AllDigital33/OpenGSE2.5/Remote Recovery Board/Schematic and PCB/FAR LR1 Remote Recovery Schematic.pdf

## OUTPUT

## BAT +

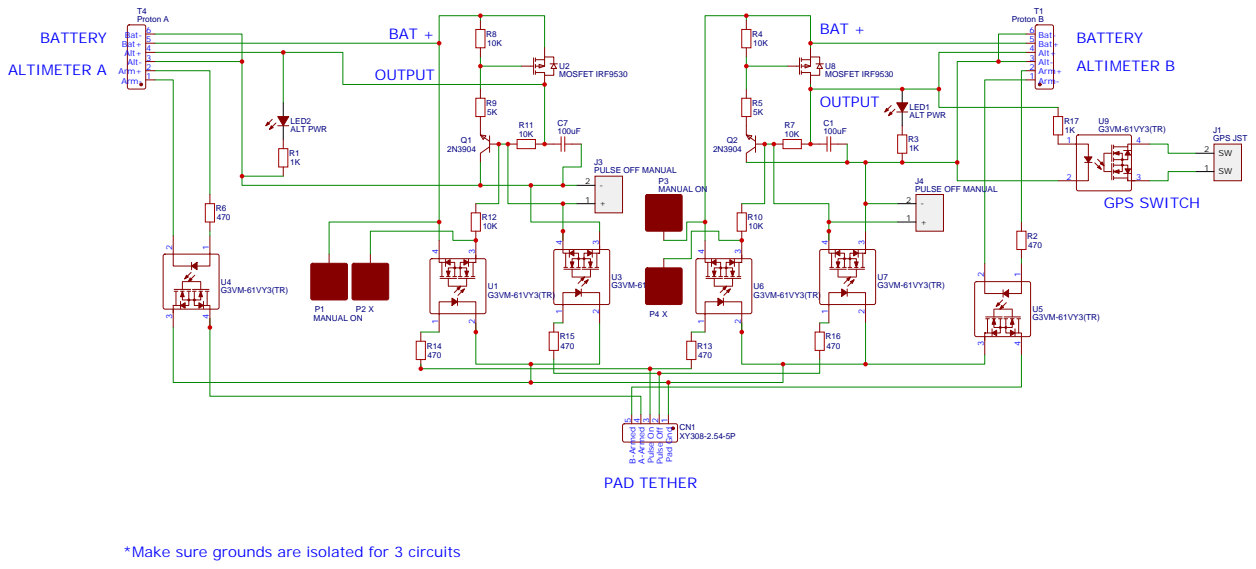
[picture p1: page 1]

*Make sure grounds are isolated for 3 circuits
