AllDigital33/OpenGSE2.5/GSE Controller/Schematic and PCB/GSE_Controller_Schematic25.pdf

## Power 24V Haz/Main

MCU and Radio power | MCU and PT power

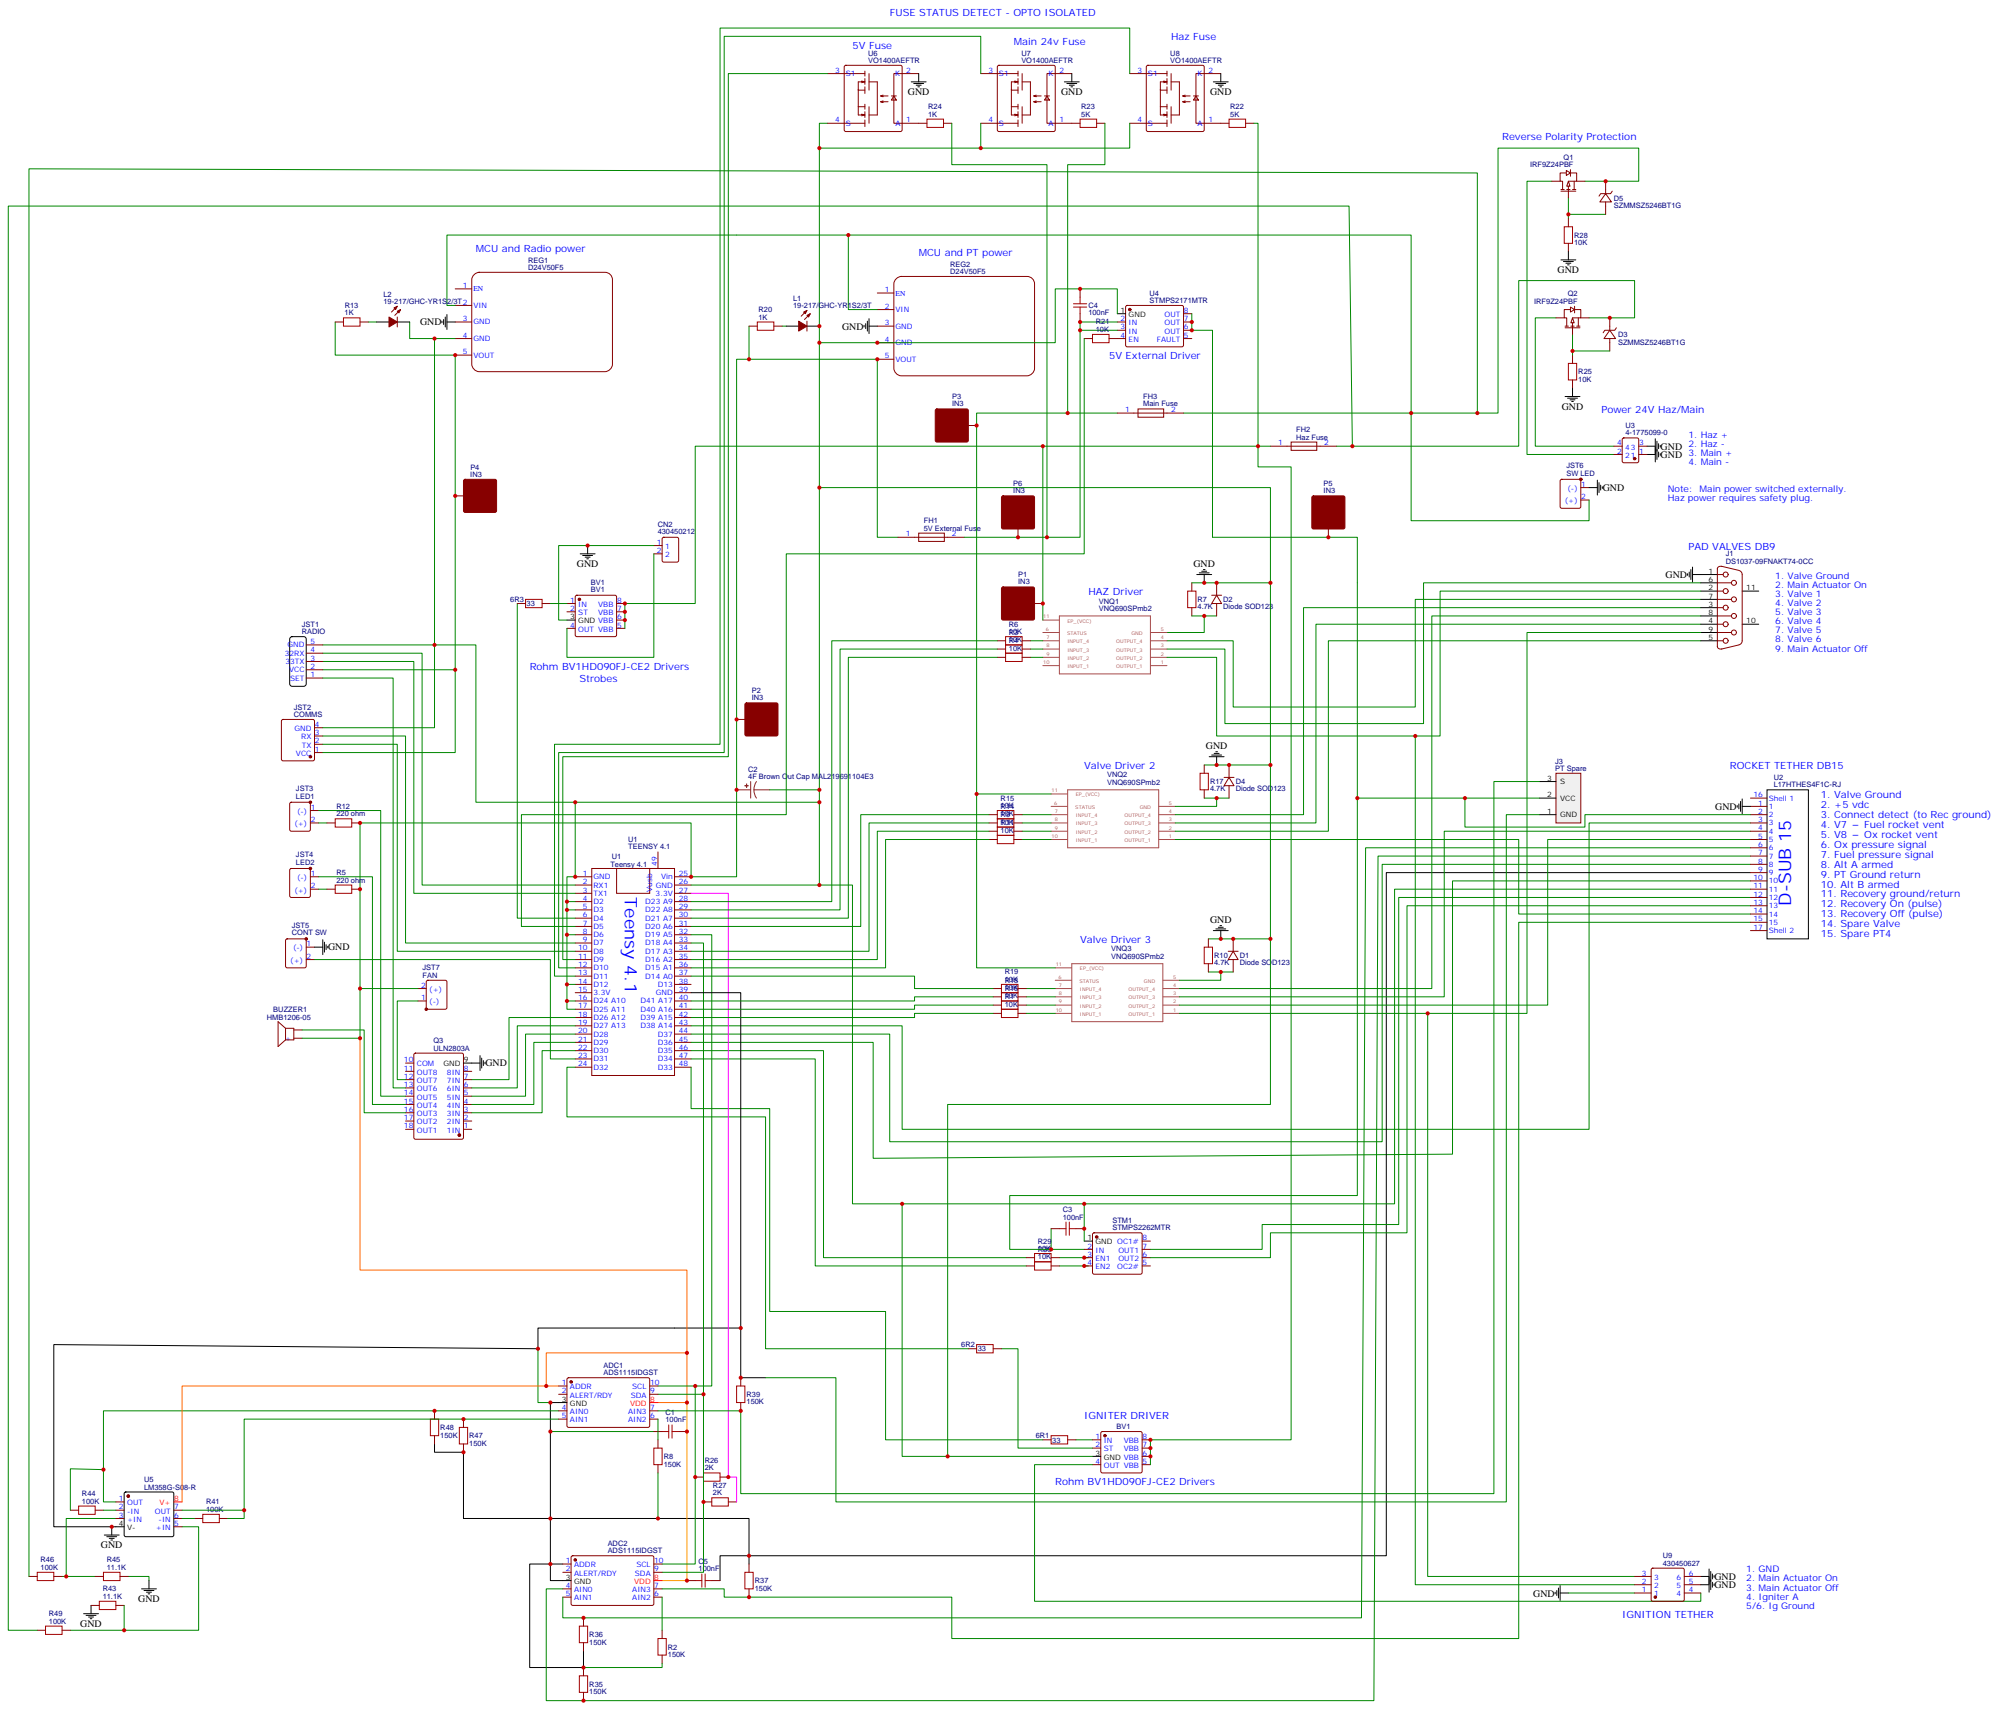
[picture p2: page 1]

FUSE STATUS DETECT - OPTO ISOLATED

Note: Main power switched externally.
Haz power requires safety plug.

1. Valve Ground
2. +5 vdc
3. Connect detect (to Rec ground)
6. Ox pressure signal
7. Fuel pressure signal
8. Alt A armed
9. PT Ground return
10. Alt B armed
11. Recovery ground/return
12. Recovery On (pulse)
13. Recovery Off (pulse)
14. Spare Valve
15. Spare PT4
