AllDigital33/OpenGSE2.5/iPad Remote/Bluetooth Bridge/Schematic and PCB/Bluetooth Bridge v16 Schematic.pdf

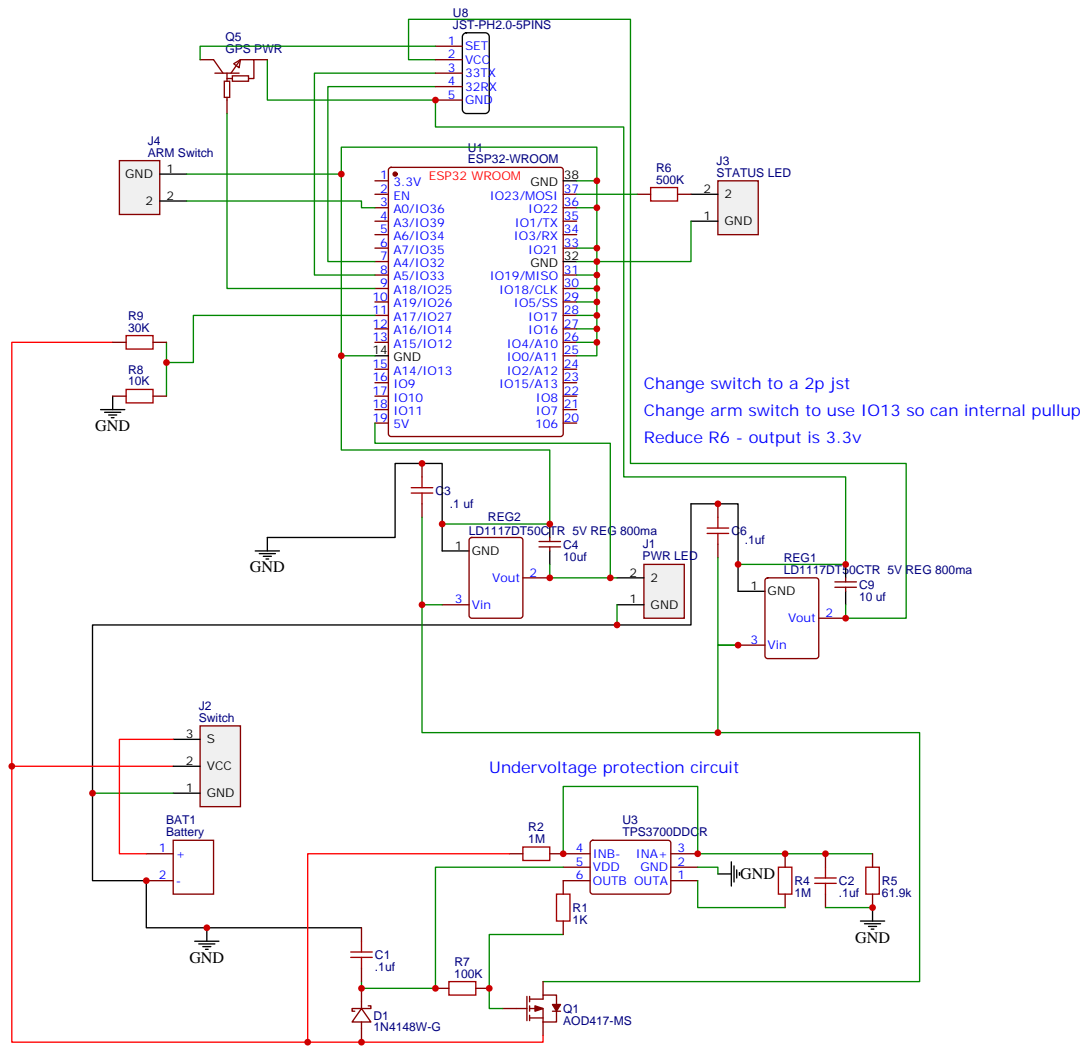
[picture p3: page 1]

Change switch to a 2p jst
Change arm switch to use IO13 so can internal pullup
Reduce R6 - output is 3.3v
