AllDigital33/OpenGSE2.5/Test Sleds/Schematic and PCB/Test Sled Pad Valves PCB.pdf

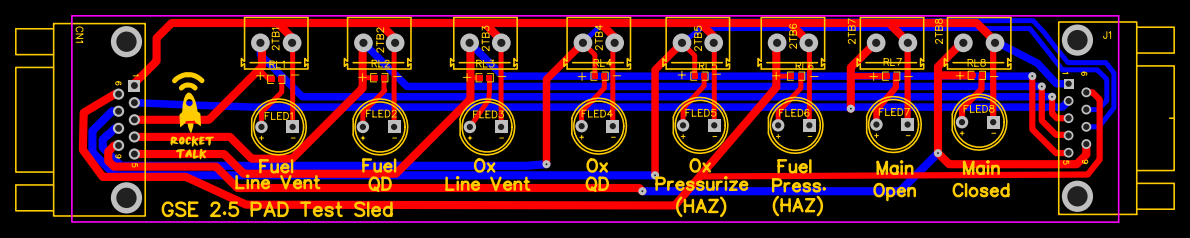
[picture p4: page 1]
