AllDigital33/OpenGSE2.5/Test Sleds/Schematic and PCB/Test Sled Pad Valves Schematic.pdf

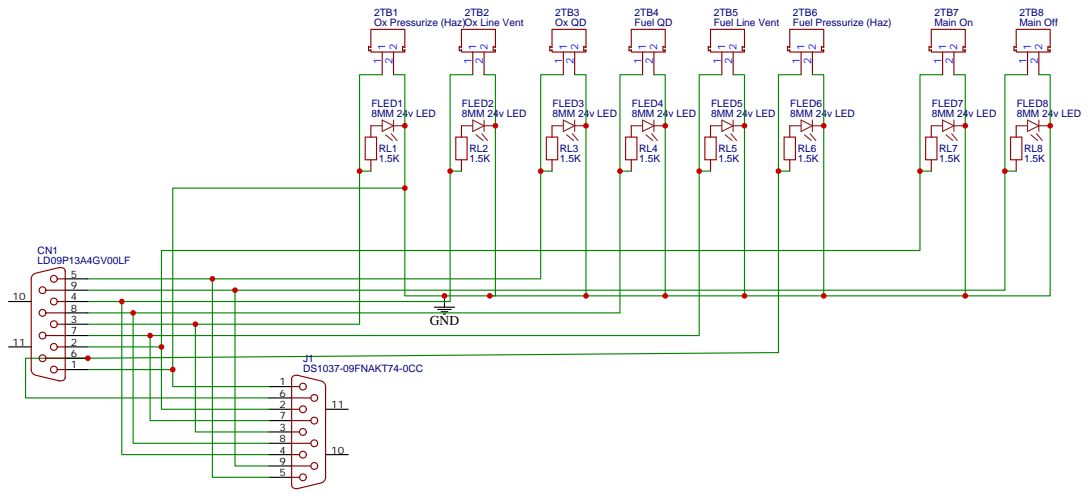
[picture p5: page 1]
