AllDigital33/OpenGSE2.5/Test Sleds/Schematic and PCB/Test Sled Rocket PCB.pdf

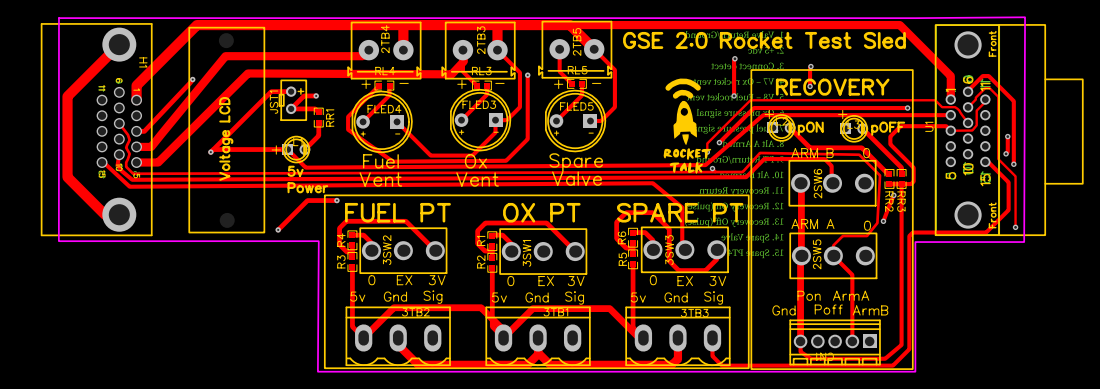
[picture p6: page 1]
