AllDigital33/OpenGSE2.5/Test Sleds/Schematic and PCB/Test Sled Rocket Schematic.pdf

# U1D⁻SUB 15

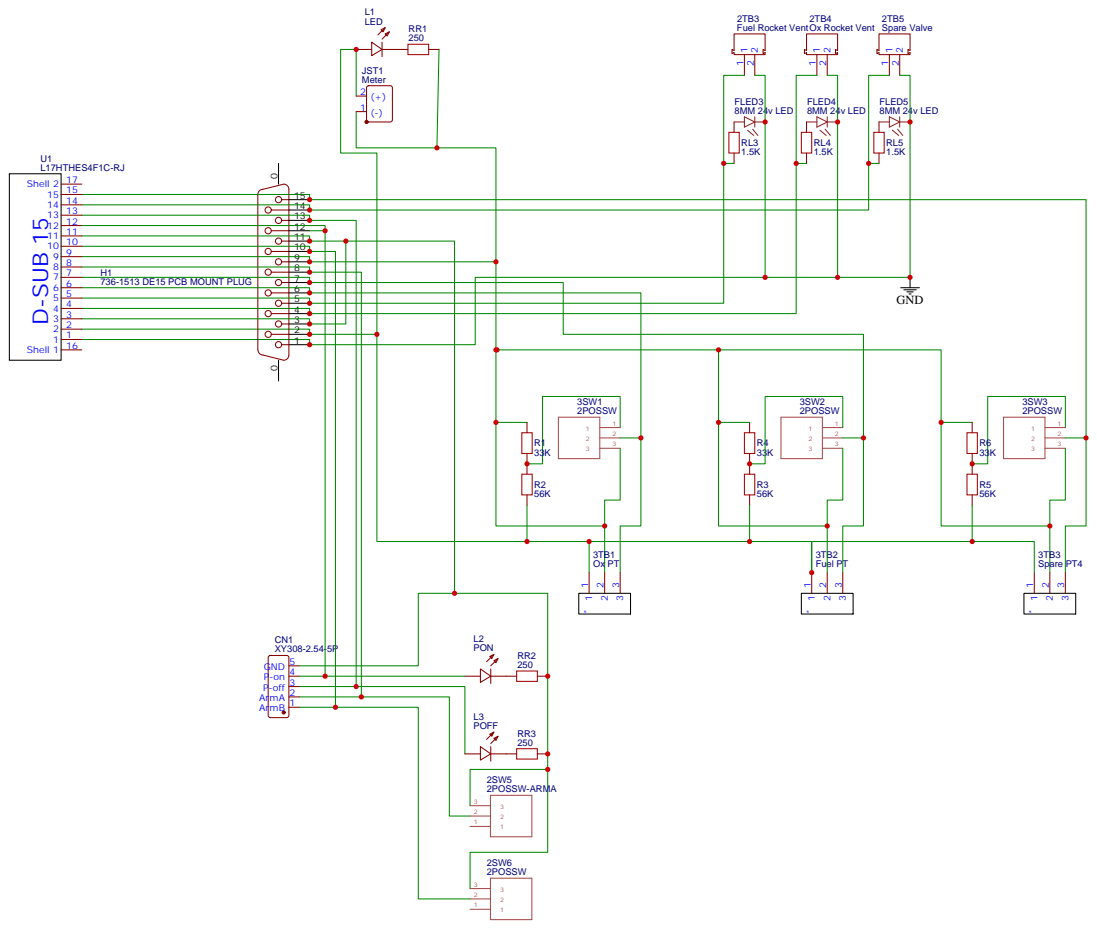
[picture p7: page 1]
