AllDigital33/OpenGSE2.5/Remote Recovery Board/Schematic and PCB/FAR LR1 Remote Recovery PCB.pdf

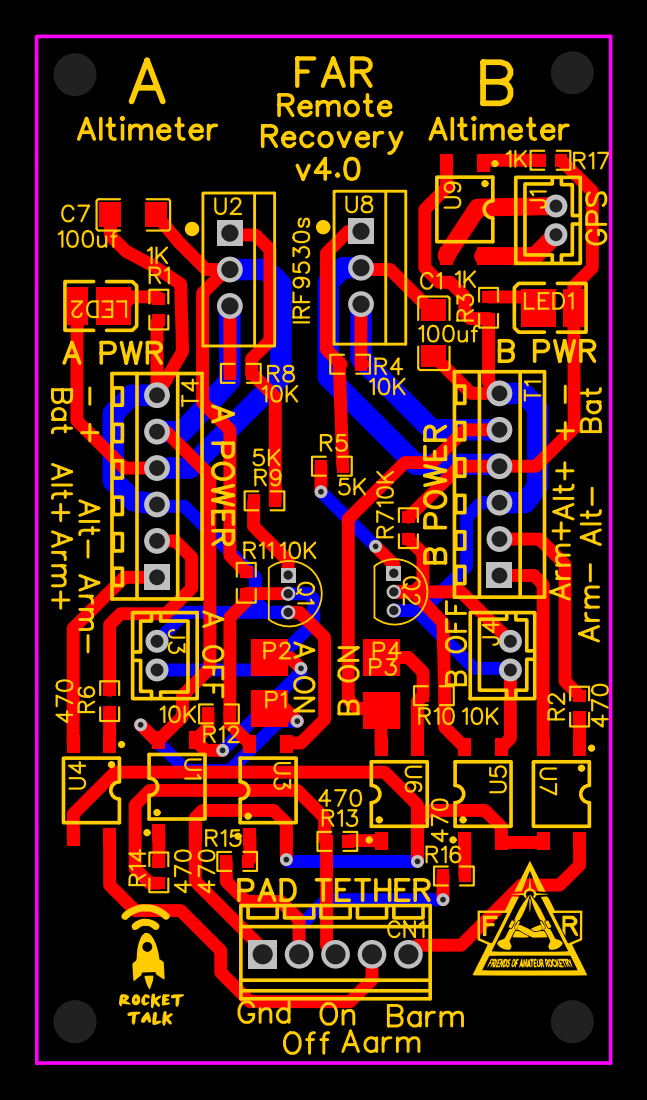
[picture p8: page 1]
