AllDigital33/OpenGSE2.5/Analog Remote/Schematic and PCB/GSE Analog Remote BOTTOM PCB v1.pdf

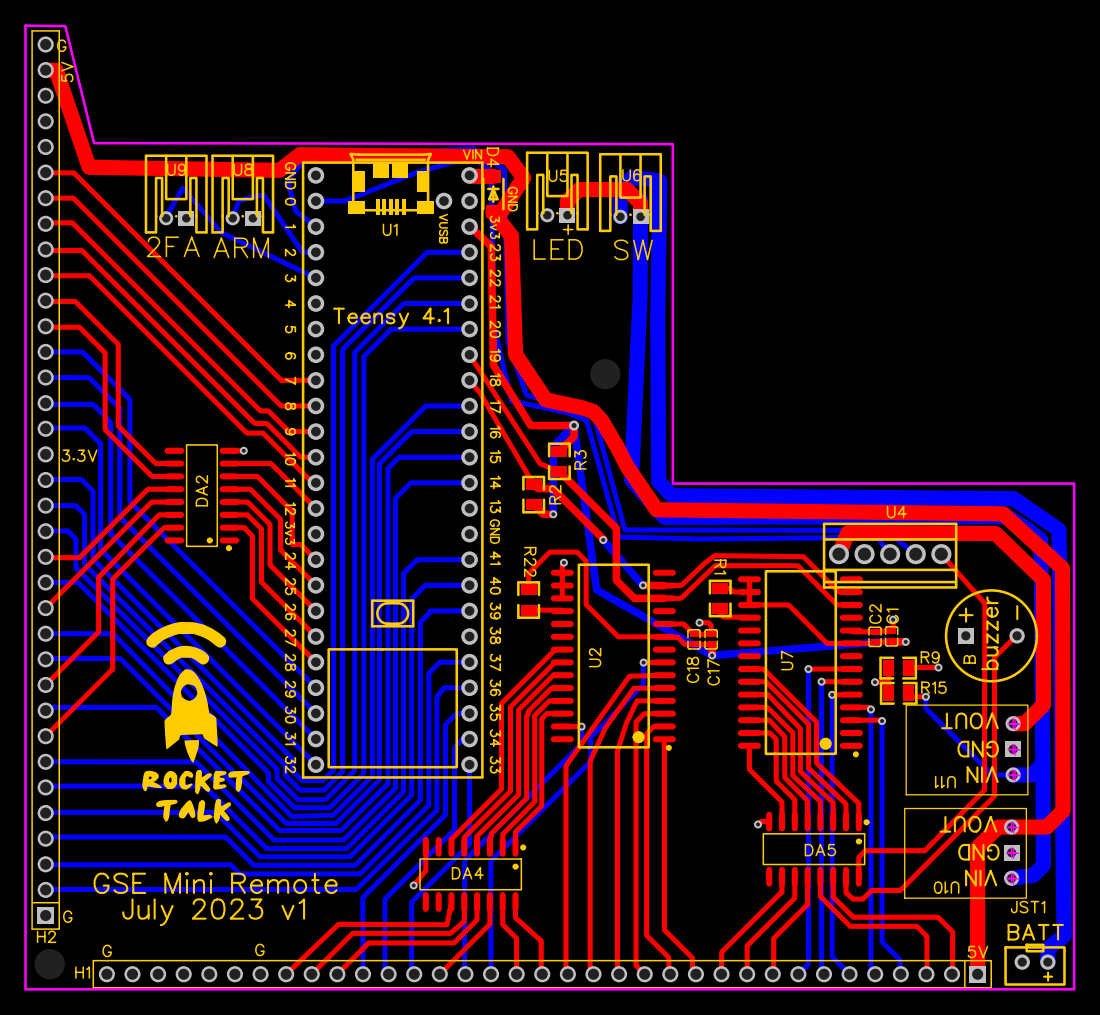
[picture p9: page 1]
