AllDigital33/OpenGSE2.5/Analog Remote/Schematic and PCB/GSE Analog Remote BOTTOM Schematic v1.pdf

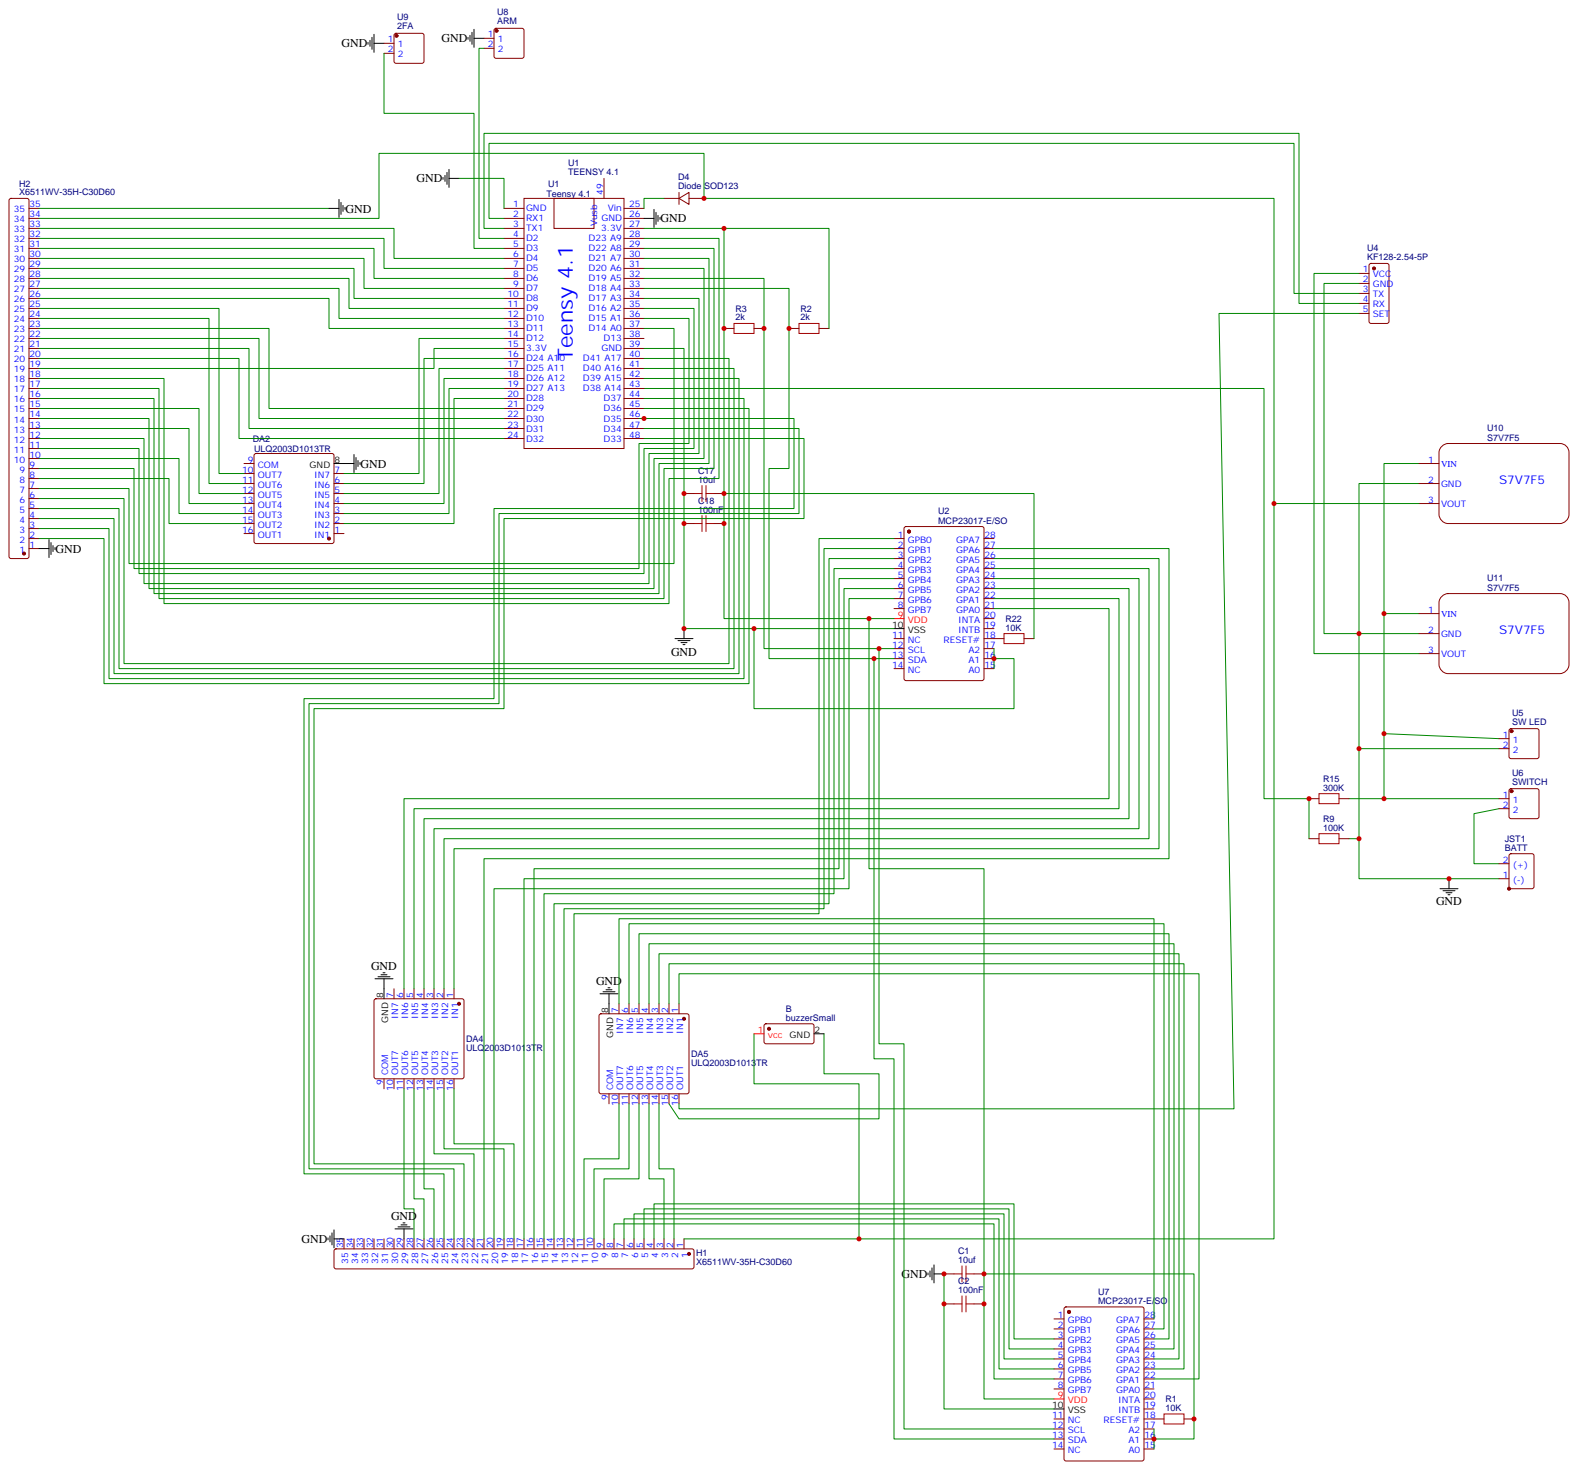
[picture p10: page 1]
