AllDigital33/OpenGSE2.5/Analog Remote/Schematic and PCB/GSE Analog Remote TOP PCB v1.pdf

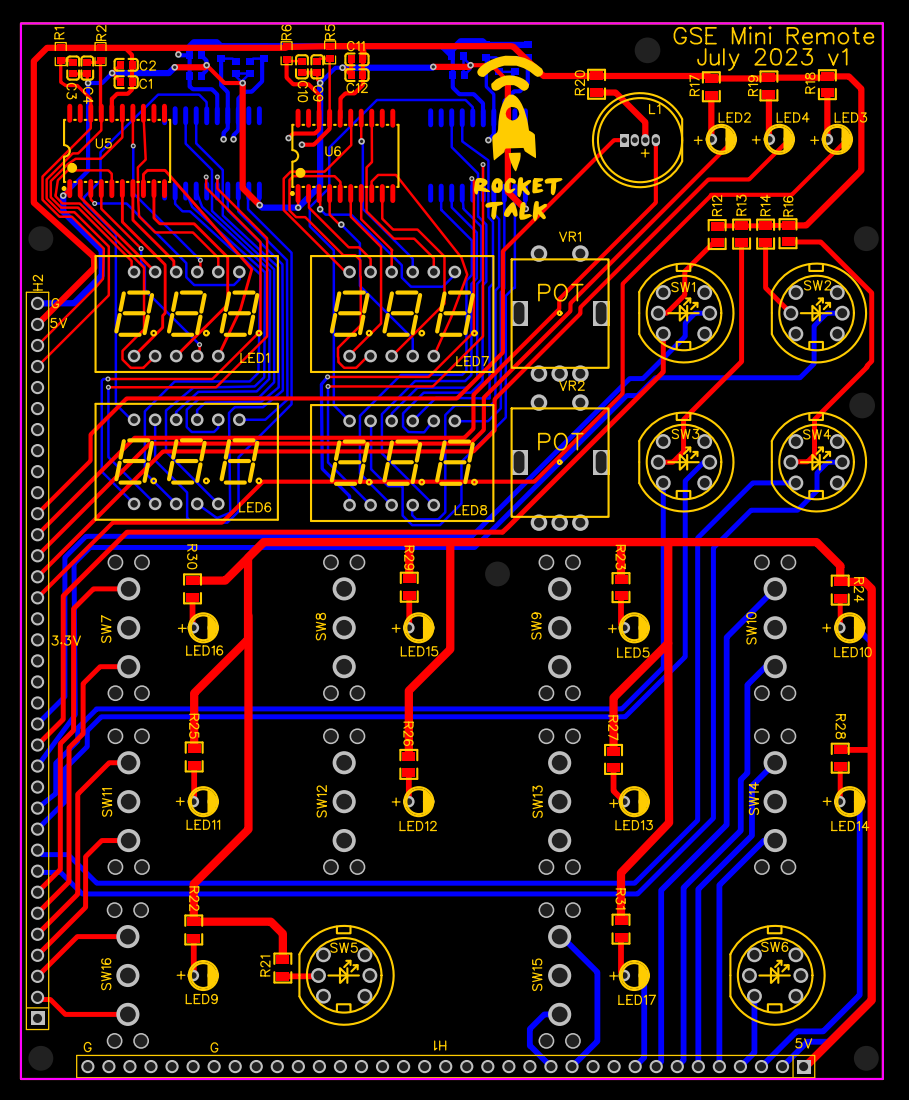
[picture p11: page 1]
