AllDigital33/OpenGSE2.5/Analog Remote/Schematic and PCB/GSE Analog Remote TOP Schematic v1.pdf

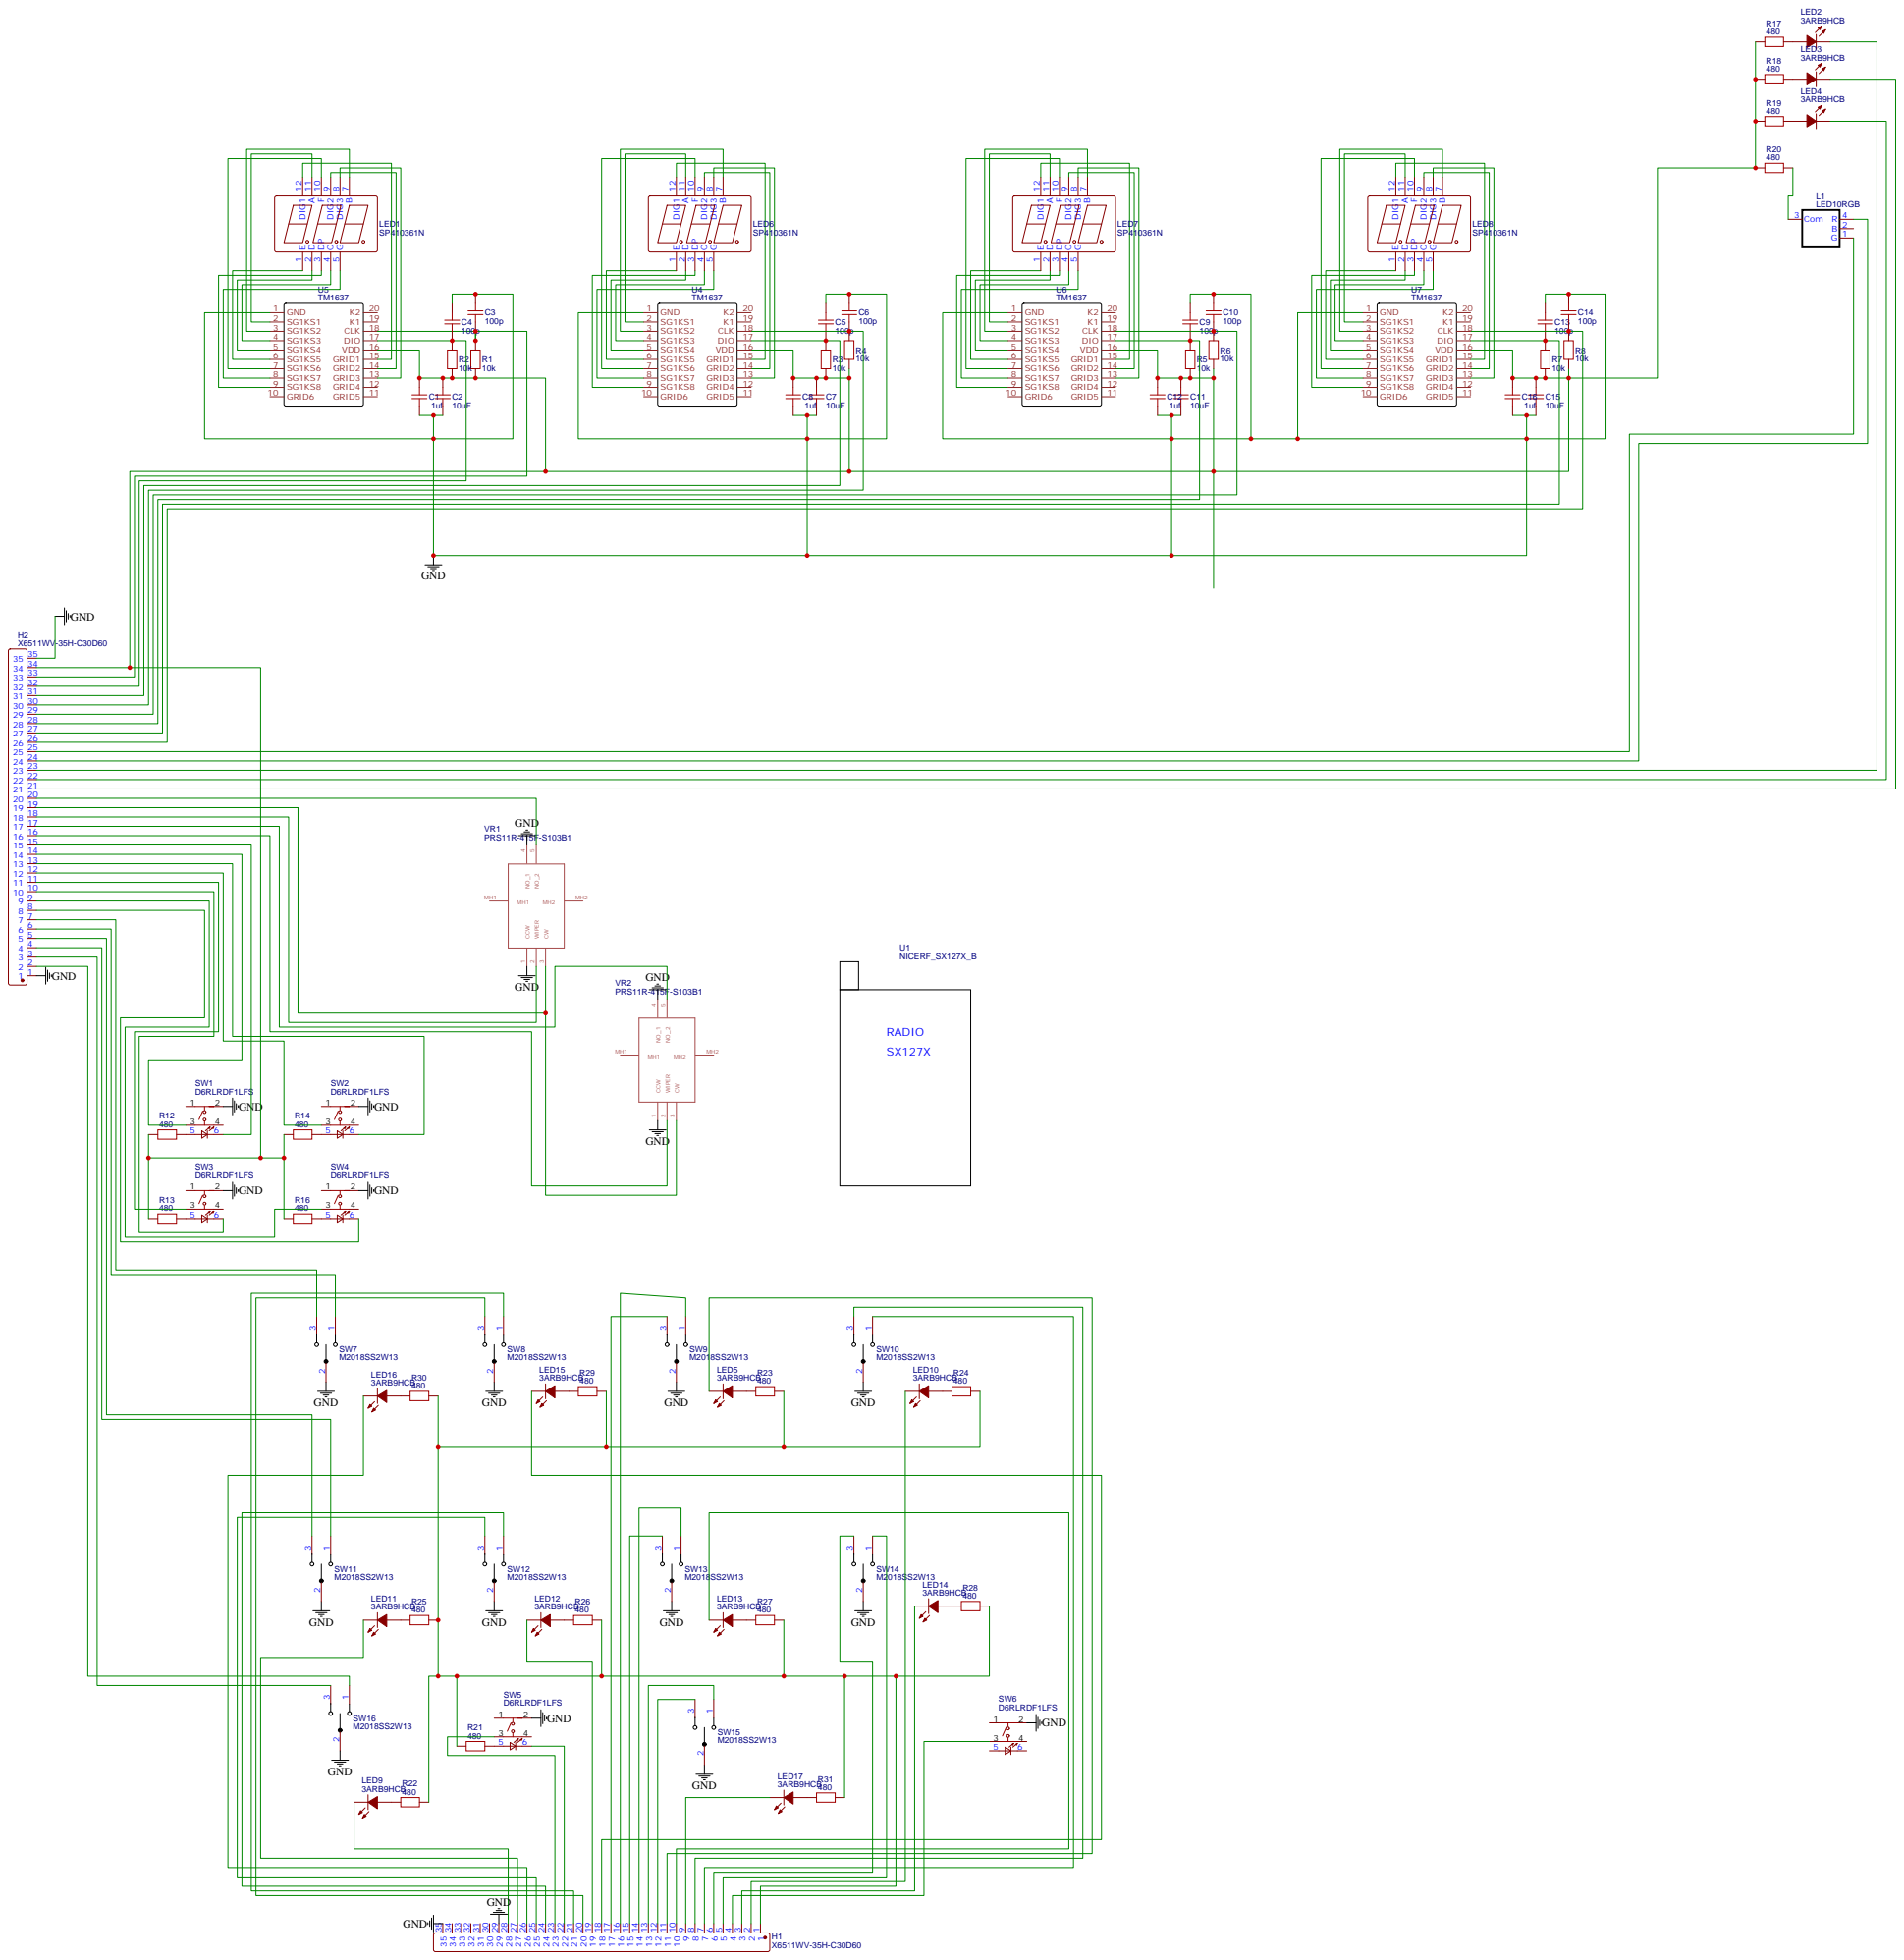
[picture p12: page 1]
