AllDigital33/OpenGSE2.5/GSE Controller/Schematic and PCB/GSE_Controller25_PCB.pdf

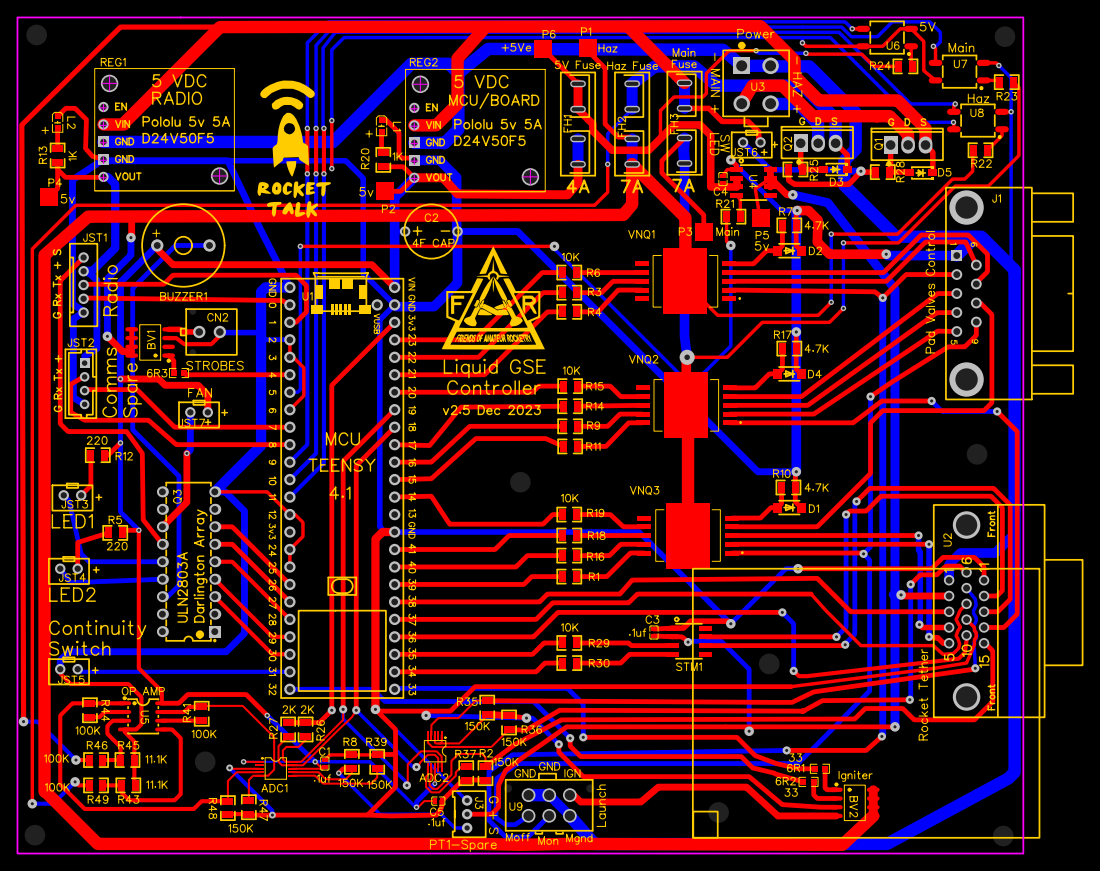
[picture p13: page 1]
