AllDigital33/OpenGSE2.5/iPad Remote/Bluetooth Bridge/Schematic and PCB/Bluetooth Bridge v16 PCB.pdf

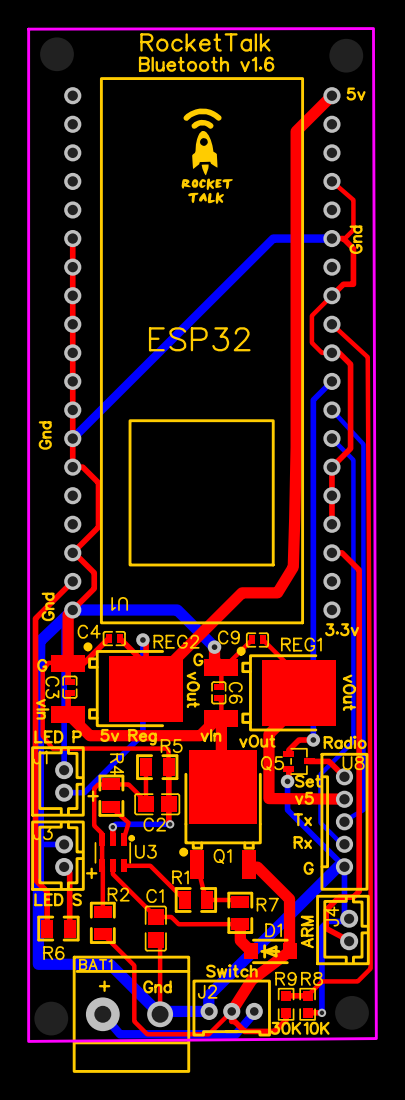
[picture p14: page 1]
