AllDigital33/OpenGSE2.5/(list of files, drawings)

Other design files:
Analog Remote/Schematic and PCB/GSE Analog Remote BOTTOM PCB v1 EasyEDA.json
Analog Remote/Schematic and PCB/GSE Analog Remote BOTTOM Schematic v1 EasyEDA.json
Analog Remote/Schematic and PCB/GSE Analog Remote TOP PCB v1 EasyEDA.json
Analog Remote/Schematic and PCB/GSE Analog Remote TOP Schematic v1 EasyEDA.json
GSE Controller/Schematic and PCB/GSE_Controller25_PCB_EasyEDA.json
GSE Controller/Schematic and PCB/GSE_Controller_Schematic25_EasyEDA.json
iPad Remote/Bluetooth Bridge/Schematic and PCB/Bluetooth Bridge v16 PCB EasyEDA.json
iPad Remote/Bluetooth Bridge/Schematic and PCB/Bluetooth Bridge v16 Schematic EasyEDA.json
Remote Recovery Board/Schematic and PCB/FAR LR1 Remote Recovery PCB EasyEDA.json
Remote Recovery Board/Schematic and PCB/FAR LR1 Remote Recovery Schematic EasyEDA.json
Test Sleds/Schematic and PCB/Test Sled Pad Valves PCB EasyEDA.json
Test Sleds/Schematic and PCB/Test Sled Pad Valves Schematic EasyEDA.json
Test Sleds/Schematic and PCB/Test Sled Rocket PCB EasyEDA.json
Test Sleds/Schematic and PCB/Test Sled Rocket Schematic EasyEDA.json
